rezapourreza91-debug/reza/experimental_validation/STL/P4_1049.stl

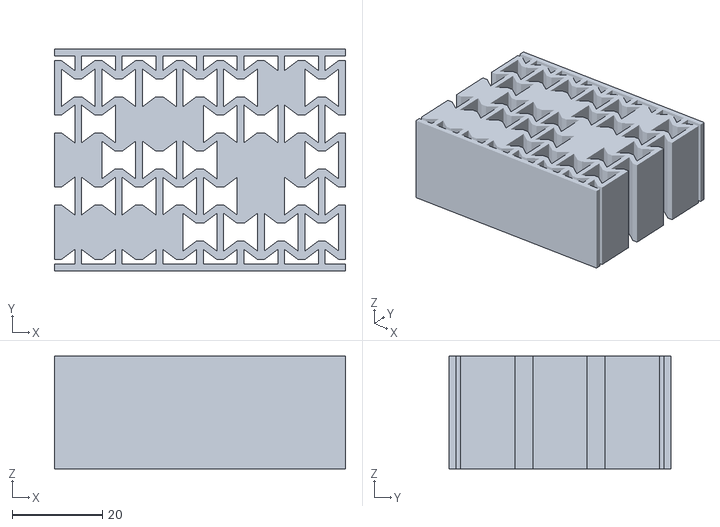
[picture p1: CAD file, 2026-10-10]
experimental_validation/STL/P4_1049.stl
64.5 x 49.1 x 25.0
