rezapourreza91-debug/reza/experimental_validation/STL/T1_tensile_ISO527-2_1BA.stl

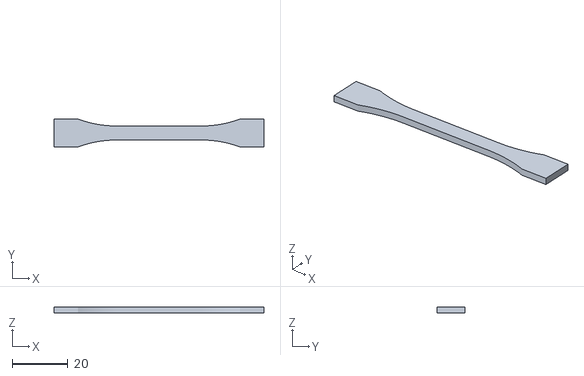
[picture p2: CAD file, 2026-10-06]
experimental_validation/STL/T1_tensile_ISO527-2_1BA.stl
75.0 x 10.0 x 2.00
