rezapourreza91-debug/reza/experimental_validation/STL/T2_compression_ASTM-D695_prism.stl

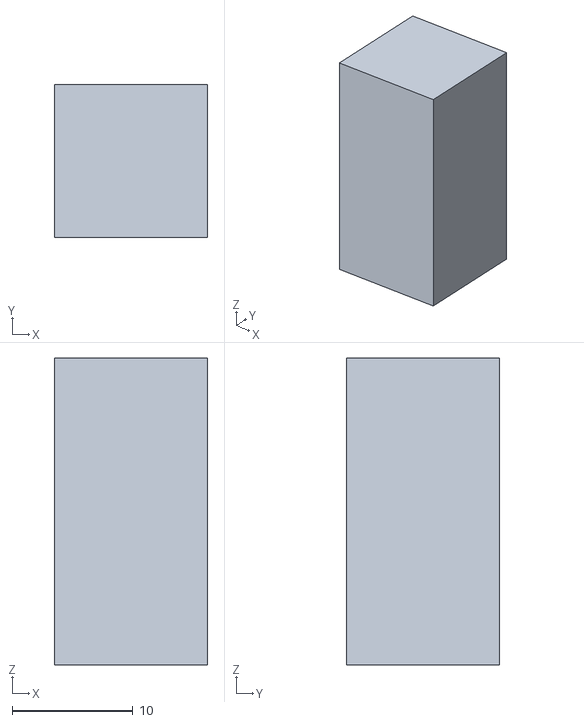
[picture p3: CAD file, 2026-10-06]
experimental_validation/STL/T2_compression_ASTM-D695_prism.stl
12.7 x 12.7 x 25.4
