rezapourreza91-debug/reza/experimental_validation/STL/X1_empty_frame.stl

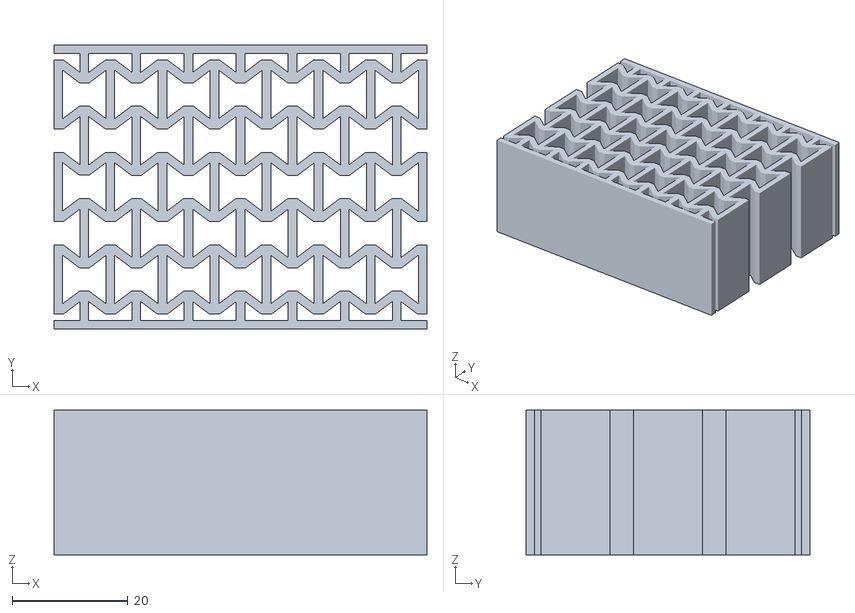
[picture p4: CAD file, 2026-10-06]
experimental_validation/STL/X1_empty_frame.stl
64.5 x 49.1 x 25.0
