rezapourreza91-debug/reza/(list of files, cad)

Other CAD files:
experimental_validation/STL/P6_BLIND_GP02.stl
experimental_validation/STL/P3_1016.stl
experimental_validation/STL/P2_1104.stl
experimental_validation/STL/P1_1097.stl
experimental_validation/STL/P5_BLIND_GP01.stl
