rezapourreza91-debug/reza/experimental_validation/REGISTRATION_amendment_P4_2026-10-10.md

# Amendment: anchor P4 changed from run 1093 to run 1049

Registered: 2026-10-10 (UTC), before any specimen of the validation set was printed or tested.
Amends the test definitions in REGISTRATION_blind_GP01_2026-10-06.md (sha256 373fc4893413db59...)
and REGISTRATION_blind_GP02_2026-10-06.md (sha256 1b980248197cd421...). Both files stay unchanged.
Neither blind prediction is affected. Do not edit this file. Any later change goes in a new, dated file.

## Reason
Run 1093 (`000000000000000000000111001111111`) fills the whole bottom row (c27-c33).
That row becomes a solid band, so the specimen behaves as a four-row lattice instead of a
five-row one, unlike every other design in the set. Raised by Ali Yadegari on 2026-10-10.
Its upside-down twin 1094 (whole top row) and runs 1095 and 1103 share the defect.

## Replacement
Run 1049 `000001001100010001100000101110000`.
Filled cells: c6 c9 c10 c14 c18 c19 c25 c27 c28 c29. n_fill = 10. Filled cells per row: 1-2-3-1-3.
Selection rule: lowest FE EA among family-A 10-fill runs with no fully filled row. Nothing else
was considered, and no experimental data exist for any design.
FE (v4 metrics): EA 85.8 J, Fplat 11.7 kN, IPCF 3.72 kN (peak), d_dens 15.3 mm, CFE 0.37.
Held-out GP prediction (5-fold CV): 97.5 J.

## Effect on the registered tests
1. Every "P4 (1093)" in the two registrations now reads "P4 (1049)". The registered order is unchanged:
   P4 (1049) < P3 (1016) < P6 (GP02) < P2 (1104) < P5 (GP01) < P1 (1097).
   The FE order of the anchors is unchanged because 85.8 J < 114.3 J (1016).
2. The calibration factor k = mean(EA_exp / EA_FE) over P1-P4 uses EA_FE(P4) = 85.8 J.
3. The upside-down comparison 1093 vs 1094 (plan criterion 4) is withdrawn, because the
   upside-down twin of 1049 (`111000000001010001100110000000010`) has not been simulated.
   It may be reinstated only if that twin is simulated before the P4 specimens are tested.
4. The blind predictions and their pass bands are unchanged: GP01 190.1 +/- 12.5 J, GP02 136.3 +/- 11.1 J.
