rezapourreza91-debug/reza/experimental_validation/REGISTRATION_blind_GP02_2026-10-06.md

# Pre-registration: blind surrogate prediction GP02 (33-cell bowtie lattice)

Registered: 2026-10-06 (UTC), before any simulation or print of this pattern.
Companion to REGISTRATION_blind_GP01_2026-10-06.md, which is unchanged.
Do not edit this file. Any later change goes in a new, dated file.

## Why a second blind design
GP01 is new but sits 6 cells from the mirror images of runs 1113 / 1121 / 1122.
GP02 is the "completely new" check requested on 2026-10-06: it is at least 8 cells
(Hamming) from every grid33 design simulated or proposed in H:\claude, from each one's
left-right mirror, up-down flip and 180-degree rotation, and from GP01 (10 cells).
Its descriptors stay inside the training range on purpose: the paper claims rank transfer
inside the design space, not extrapolation beyond it.

## Pattern
`000011000011001010000010010000101`  (c1..c33, c1 = top-left, row by row, 7-6-7-6-7)
Filled cells: c5 c6 c11 c12 c15 c17 c23 c26 c31 c33. n_fill = 10.
Descriptors: adj_v 0.6, adj_h 0.2, percolate 0, n_paths 0, vspan_max 0.8 (a vertical chain
broken in one row), y_cm 0.50, x_cm 0.64.
Nearest simulated runs (any symmetry image): 1020, 1024, 1029, 1055, 1071, 1072, 1077, all at
Hamming 8 (blind_GP02_hamming_audit.csv).

## Model
Same as GP01: `inverse_design_v4.Surrogate`, unchanged, trained on UNIFIED_DATASET_v4.xlsx
(201 rows, SW_33_SIN quarantined), seed 0. Family-A 5-fold CV: EA_J R2 0.79, MAE 9.6 J.
Selection: 200,000 random 10-of-33 patterns, novelty filter (>= 8 from all 893 vectors),
then the candidate whose prediction sits furthest, in sd units, from both neighbouring
ladder designs P3 (1016, 114.3 J) and P2 (1104, 159.6 J).

## Predictions (FE-equivalent, full 25 mm depth)
| quantity | prediction |
|---|---|
| EA_J (0-to-d_dens, project v4 definition) | **136.3 +/- 11.1 J** (1 sd) |
| Fplat_kN | 15.6 +/- 1.0 kN |
| d_dens_mm | 16.0 mm |
| CFE (composed) | 0.42 |

## Registered tests (compression, n = 3, same spool and machine as P1-P5)
1. **Rank (primary).** Mean experimental EA orders the six designs as
   P4 (1093) < P3 (1016) < **P6 (GP02)** < P2 (1104) < P5 (GP01) < P1 (1097).
   Pass for GP02: it lies strictly between 1016 and 1104. Spearman over the six designs = 1.0
   (chance probability 1/720 = 0.0014); rho >= 0.9 is reported as a partial pass.
2. **Level after one-shot calibration.** k = mean(EA_exp / EA_FE) over P1-P4.
   Pass: |EA_exp(GP02) - k * 136.3| <= 2 * k * 11.1 J.
3. **Raw level** is reported, not claimed (FE over-predicted force ~15 % on the 5x5 specimen).
