rezapourreza91-debug/reza/experimental_validation/REGISTRATION_blind_GP01_2026-10-06.md

# Pre-registration: blind surrogate prediction GP01 (33-cell bowtie lattice)

Registered: 2026-10-06 (UTC), before any simulation or print of this pattern.
Do not edit this file. Any later change goes in a new, dated file.

## Pattern
`000110000011000001100001010001001`  (c1..c33, c1 = top-left, row by row, 7-6-7-6-7)
Filled cells: c4 c5 c11 c12 c18 c19 c24 c26 c30 c33. n_fill = 10 (same mass as every P1-P4 specimen).
Descriptors: adj_v 1.0, percolate 1, n_paths 2, y_cm 0.50, x_cm 0.68.
Novelty: Hamming >= 6 against all 281 grid33 designs simulated or proposed in H:\claude
(including their left-right mirrors and up-down flips, 889 vectors); nearest simulated runs
1119 / 1120 / 1084 at Hamming 8 (see blind_GP01_hamming_audit.csv).

## Model
`inverse_design_v4.Surrogate` (H:\claude), unchanged: GP, Matern 2.5 + white noise, 22 inputs,
trained on UNIFIED_DATASET_v4.xlsx (201 rows, SW_33_SIN quarantined per DATA_MANIFEST), seed 0.
Own 5-fold CV on family A (119 runs): EA_J R2 0.79, MAE 9.6 J, Spearman 0.79.
Known bias: on FE runs with EA > 165 J the held-out prediction is LOW by 9.3 J on average.
Selection: 60,000 random 10-of-33 patterns, novelty filter, then local search on EA_pred - 1 sd;
GP01 was chosen as the candidate whose prediction sits furthest (in sd units) from both
neighbouring ladder designs (P2 = 1104 and P1 = 1097).

## Predictions (FE-equivalent, full 25 mm depth)
| quantity | prediction |
|---|---|
| EA_J (0-to-d_dens, project v4 definition) | **190.1 +/- 12.5 J** (1 sd) |
| Fplat_kN | 18.0 +/- 1.1 kN |
| d_dens_mm | 16.6 mm |
| CFE (composed) | 0.49 |

## Registered tests (compression, n = 3 per design, same spool, same machine)
1. **Rank (primary).** Mean experimental EA orders the five designs as
   P4 (1093) < P3 (1016) < P2 (1104) < **P5 (GP01)** < P1 (1097).
   Pass: GP01 lies strictly between 1104 and 1097. Spearman over the five designs = 1.0
   (chance probability 1/120 = 0.008); rho >= 0.9 is reported as a partial pass.
2. **Level after one-shot calibration (secondary).** k = mean(EA_exp / EA_FE) over P1-P4.
   Pass: |EA_exp(GP01) - k * 190.1| <= 2 * k * 12.5 J.
3. **Raw level (expected to FAIL; reported, not claimed).** The 5x5 comparison showed the FE
   over-predicting force by ~15 %; the paper's thesis is that level does not transfer.

## Optional, after this file is frozen
Run GP01 in Abaqus with the production deck. That gives a GP-vs-FE check and makes the
comparison three-way (GP, FE, experiment). The FE result must not change the predictions above.
