rezapourreza91-debug/reza/experimental_validation/validation_patterns_v1.csv

specimen | role | pattern | n_fill | family | FE_EA_J | FE_IPCF_kN | FE_IPCF_kind | FE_Fplat_kN | FE_Fmax_kN | FE_ULC | FE_CFE | FE_d_dens_mm | adj_v | percolate | n_paths | GP_heldout_EA_J | c1 | c2 | c3 | c4 | c5 | c6 | c7 | c8 | c9 | c10 | c11 | c12 | c13 | c14 | c15 | c16 | c17 | c18 | c19 | c20 | c21 | c22 | c23 | c24 | c25 | c26 | c27 | c28 | c29 | c30 | c31 | c32 | c33 | GP_EA_J | GP_EA_sd_J | GP_Fplat_kN | GP_Fplat_sd_kN | GP_d_dens_mm
P1_1097 | high end of ladder (best, knee) | 000100000110000111000011000010100 | 10 | A_grid33_std | 214.5575903587366 | 2.56321 | knee | 17.31245039746879 | 22.6725 | 0.1240808755438122 | 0.5379771370331169 | 17.5906 | 1.2 | 1.0 | 1.0 | 198.1 | 0 | 0 | 0 | 1 | 0 | 0 | 0 | 0 | 0 | 1 | 1 | 0 | 0 | 0 | 0 | 1 | 1 | 1 | 0 | 0 | 0 | 0 | 1 | 1 | 0 | 0 | 0 | 0 | 1 | 0 | 1 | 0 | 0
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
