rezapourreza91-debug/reza/experimental_validation/blind_GP02_hamming_audit.csv

hamming | run | image | EA_J
8 | 1020 | UD | 128.3
8 | 1024 | as-is | 134.7
8 | 1029 | UD | 122.4
8 | 1055 | LR | 135.3
8 | 1055 | rot180 | 135.3
8 | 1071 | UD | 106.9
8 | 1072 | UD | 109.9
8 | 1077 | as-is | 106.5
