rezapourreza91-debug/reza/experimental_validation/blind_GP01_hamming_audit.csv

nearest_run | hamming | EA_J
1119 | 8 | 170.3
1120 | 8 | 154.4
1084 | 8 | 134.8
SW_08_RAN | 8 | 73.8
LP_15_P1 | 9 | 219.5
