rezapourreza91-debug/reza/experimental_validation/patterns_preview.png

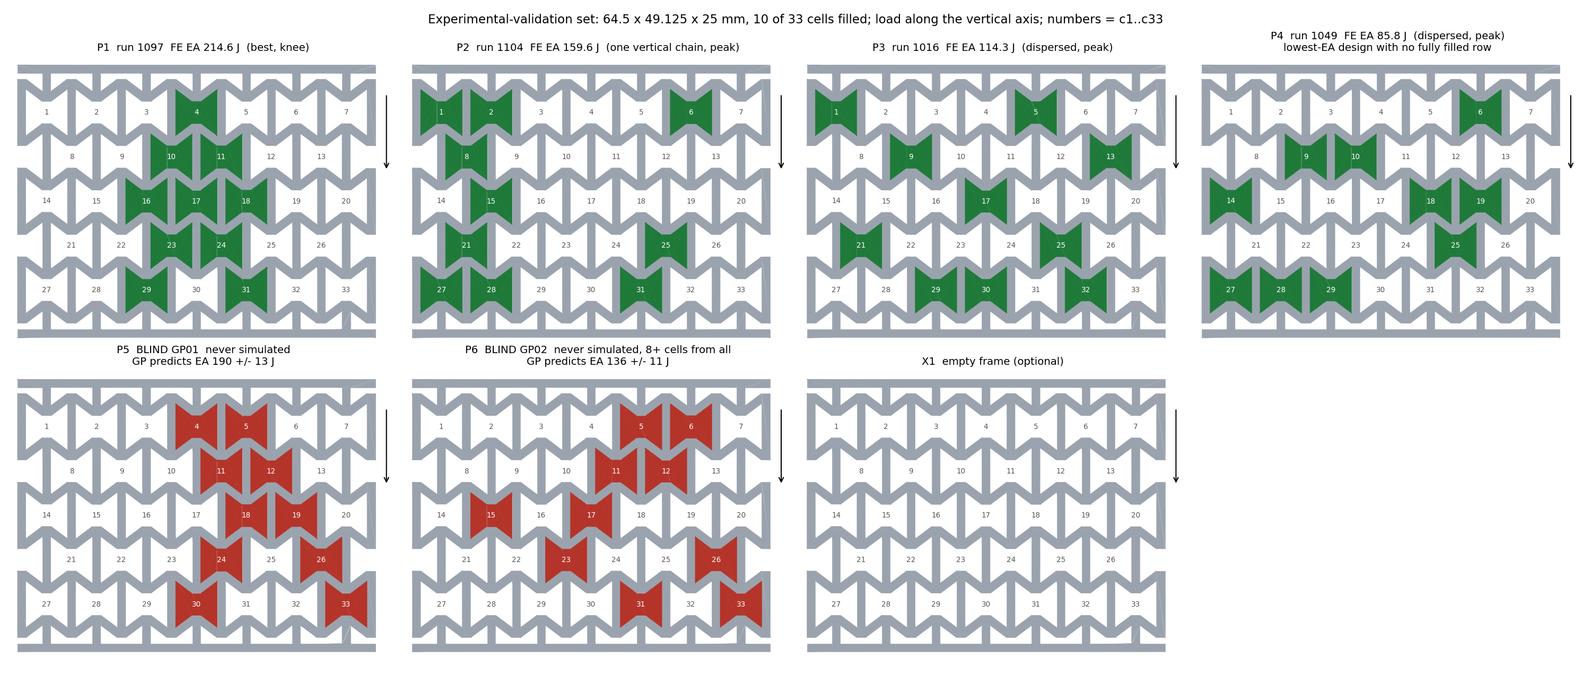
experimental_validation/patterns_preview.png
