rezapourreza91-debug/reza/(commit log)

2026-10-06 Add experimental validation set and blind GP01 pre-registration
    Five 10-of-33 patterns (1097, 1104, 1016, 1093, blind GP01) with printable
    STLs, tensile/compression coupons, and the frozen GP01 prediction
    (EA 190.1 +/- 12.5 J, rank between 1104 and 1097).
    Claude-Session: https://claude.ai/code/session_01C9WXmyDUqkF1aeWMit78jq
    [P1_1097.stl, P2_1104.stl, P3_1016.stl, P4_1093.stl, P5_BLIND_GP01.stl, T1_tensile_ISO527-2_1BA.stl, T2_compression_ASTM-D695_prism.stl, X1_empty_frame.stl]
2026-10-06 Add second blind design GP02 and its pre-registration
    GP02 (000011000011001010000010010000101) differs by at least 8 cells from
    every simulated or proposed design and their symmetry images. Predicted
    EA 136.3 +/- 11.1 J, registered rank P4 < P3 < P6 < P2 < P5 < P1.
    GP01 registration is unchanged. Adds P6 STL and updates the plan,
    manifest, preview and pattern table to six designs.
    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
    [P6_BLIND_GP02.stl, blind_GP02_hamming_audit.csv, validation_patterns_v1.csv]
2026-10-10 Replace anchor P4 (run 1093) with run 1049 before any testing
    Run 1093 fills the whole bottom row, so the specimen behaves as a
    four-row lattice. Run 1049 is the lowest-EA family-A 10-fill design
    with no fully filled row (FE EA 85.8 J). The GP01 and GP02
    registrations are unchanged; the dated amendment records the new
    anchor, keeps the registered order, and withdraws the 1093/1094
    upside-down comparison.
    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
    [P4_1049.stl, P4_1093.stl, validation_patterns_v1.csv]
